cookhome/IoT/(commit log)

2017-05-27 NodeMCU
    NodeMCU LUA script to control garage door switch and light
2017-05-31 update circuit drawings
2017-07-09 update with Arduino
2017-07-10 updated with Arduino
